ThisWillGoWell/DinoLight/images/neopixel_drver.png

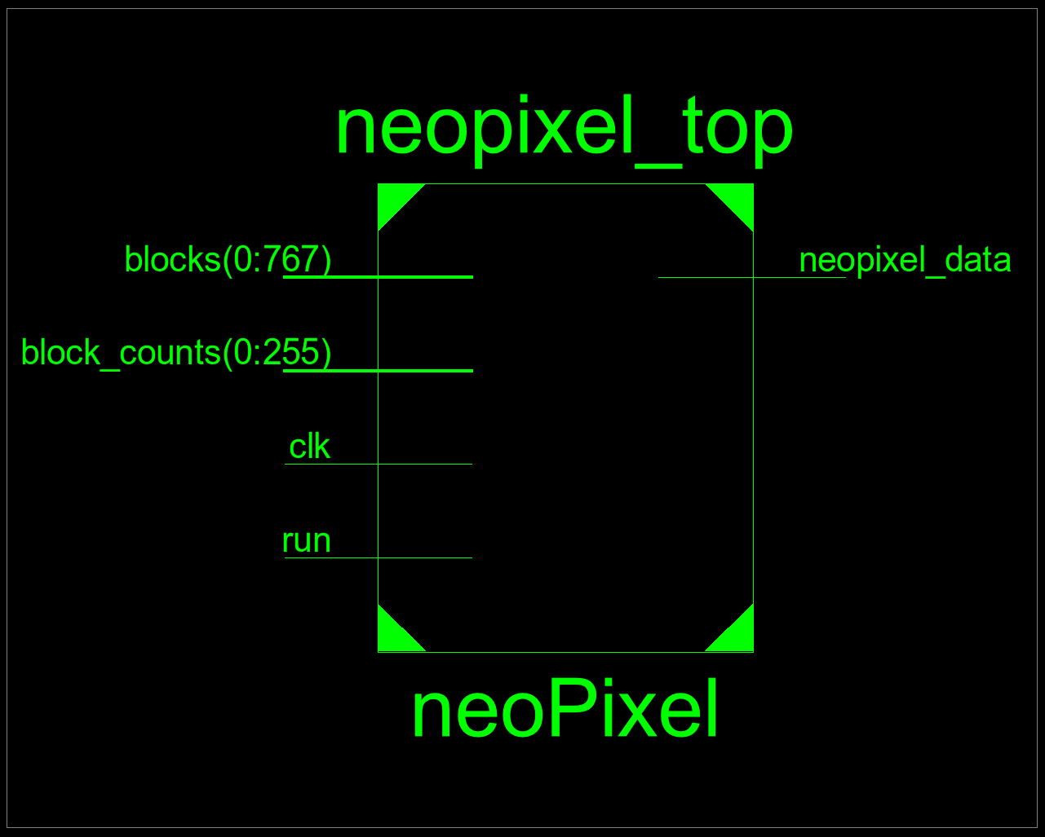
images/neopixel_drver.png
