ThisWillGoWell/DinoLight/images/projector-back.jpg

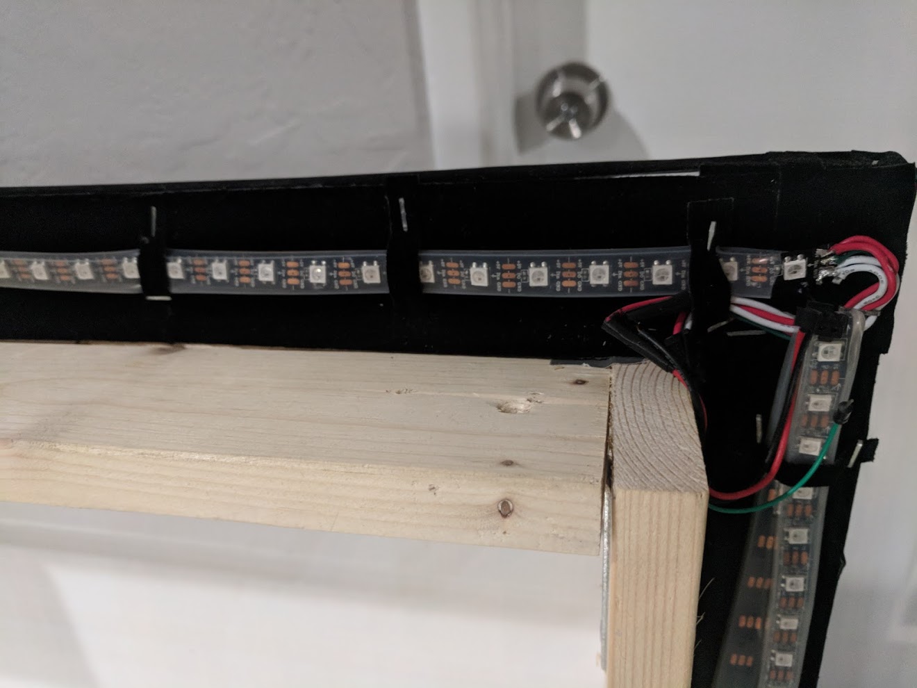
images/projector-back.jpg
