ThisWillGoWell/DinoLight/HDL/ise_project/dinolight/par_usage_statistics.html

Par Statistics

Total Non-vccgnd Signals=10460

Total Non-vccgnd Design Pins=26982

Total Non-vccgnd Conns=26982

Total Non-vccgnd Timing Constrained Conns=26282

Phase 1 CPU=5.9 sec

Phase 2 CPU=7.2 sec

Phase 3 CPU=19.3 sec

Phase 4 CPU=20.1 sec

Phase 5 CPU=31.5 sec

Phase 6 CPU=31.5 sec

Phase 7 CPU=31.5 sec

Phase 8 CPU=31.5 sec

Phase 9 CPU=31.5 sec

Phase 10 CPU=32.9 sec

AvgWirelenPerPin Fanout 1=2.0

AvgWirelenPerPin Fanout 2=1.5

AvgWirelenPerPin Fanout 3=1.0

AvgWirelenPerPin Fanout 4=3.8

AvgWirelenPerPin Fanout 10=2.5

AvgWirelenPerPin Fanout 50=8.6

AvgWirelenPerPin Fanout 100=10.8

AvgWirelenPerPin Fanout 500=8.4

AvgWirelenPerPin Fanout 5000=4.9

AvgWirelenPerPin Fanout 20000=0.0

AvgWirelenPerPin Fanout 50000=0.0

AvgWirelenPerPin Fanout 100000=0.0

IRR Gamma=4.1229
