ThisWillGoWell/DinoLight/HDL/ise_project/dinolight/usage_statistics_webtalk.html

### Device Usage Page (usage_statistics_webtalk.html)

This HTML page displays the device usage statistics that will be sent to Xilinx.

Software Version and Target Device
Product Version: | ISE:14.7 (WebPack) - P.20131013 | Target Family: | Spartan6
OS Platform: | LIN64 | Target Device: | xc6slx25
Project ID (random number) | 8b87126f18c546c1a701c0b1ea19649f.E9EB84C8A79649F5B47BB80CAE17756E.8 | Target Package: | ftg256
Registration ID | 211341362_0_0_377 | Target Speed: | -3
Date Generated | 2018-03-15T22:13:49 | Tool Flow | ISE

User Environment
OS Name | Ubuntu | OS Release | Ubuntu 16.04.3 LTS
CPU Name | Intel(R) Core(TM) i7-7700K CPU @ 4.20GHz | CPU Speed | 4200.000 MHz
OS Name | Ubuntu | OS Release | Ubuntu 16.04.3 LTS
CPU Name | Intel(R) Core(TM) i7-7700K CPU @ 4.20GHz | CPU Speed | 4200.000 MHz

Device Usage Statistics
Macro Statistics | Miscellaneous Statistics | Net Statistics | Site Usage

Accumulators=96

22-bit up accumulator=96

Adders/Subtractors=4

3-bit adder=2

9-bit adder=2

Comparators=45

11-bit comparator greater=18

11-bit comparator lessequal=16

12-bit comparator greater=4

3-bit comparator greater=2

5-bit comparator greater=1

7-bit comparator equal=1

8-bit comparator equal=1

9-bit comparator greater=2

Counters=11

11-bit up counter=2

12-bit up counter=1

15-bit up counter=1

24-bit up counter=1

4-bit up counter=2

5-bit up counter=1

6-bit up counter=1

7-bit up counter=1

8-bit up counter=1

FSMs=6 Multiplexers=3102

1-bit 2-to-1 multiplexer=3066

1-bit 8-to-1 multiplexer=1

10-bit 2-to-1 multiplexer=24

3-bit 2-to-1 multiplexer=4

9-bit 2-to-1 multiplexer=7

RAMs=4

256x8-bit single-port block Read Only RAM=3

4x8-bit single-port distributed Read Only RAM=1

Registers=8782

Flip-Flops=8782

Xors=1752

1-bit xor2=1746

5-bit xor2=3

9-bit xor2=3

MiscellaneousStatistics

AGG_BONDED_IO=20

AGG_IO=20

AGG_LOCED_IO=20

AGG_SLICE=2104

NUM_BONDED_IOB=20

NUM_BSFULL=5265

NUM_BSLUTONLY=452

NUM_BSREGONLY=2060

NUM_BSUSED=7777

NUM_BUFG=4

NUM_BUFPLL=1

NUM_ISERDES2=6

NUM_LOCED_IOB=20

NUM_LOGIC_O5ANDO6=603

NUM_LOGIC_O5ONLY=1161

NUM_LOGIC_O6ONLY=2852

NUM_LUT_RT_DRIVES_CARRY4=90

NUM_LUT_RT_DRIVES_FLOP=666

NUM_LUT_RT_EXO5=666

NUM_LUT_RT_EXO6=90

NUM_LUT_RT_O5=9

NUM_LUT_RT_O6=1161

NUM_PLL_ADV=1

NUM_RAMB8BWER=2

NUM_SLICEL=530

NUM_SLICEM=89

NUM_SLICEX=1485

NUM_SLICE_CARRY4=525

NUM_SLICE_CONTROLSET=83

NUM_SLICE_CYINIT=7916

NUM_SLICE_F7MUX=6

NUM_SLICE_FF=8884

NUM_SLICE_UNUSEDCTRL=168

NUM_SRL_O5ANDO6=336

NUM_SRL_O6ONLY=9

NUM_UNUSABLE_FF_BELS=267

NetStatistics

NumNets_Active=10480

NumNets_Gnd=1

NumNets_Vcc=1

NumNodesOfType_Active_BOUNCEACROSS=164

NumNodesOfType_Active_BOUNCEIN=1444

NumNodesOfType_Active_BUFGOUT=4

NumNodesOfType_Active_BUFHINP2OUT=27

NumNodesOfType_Active_CLKPIN=1944

NumNodesOfType_Active_CLKPINFEED=43

NumNodesOfType_Active_CNTRLPIN=1627

NumNodesOfType_Active_DOUBLE=9265

NumNodesOfType_Active_GENERIC=28

NumNodesOfType_Active_GENERIC1=5

NumNodesOfType_Active_GLOBAL=427

NumNodesOfType_Active_INPUT=817

NumNodesOfType_Active_IOBIN2OUT=14

NumNodesOfType_Active_IOBINPUT=3

NumNodesOfType_Active_IOBOUTPUT=23

NumNodesOfType_Active_LUTINPUT=18264

NumNodesOfType_Active_OUTBOUND=10060

NumNodesOfType_Active_OUTPUT=10544

NumNodesOfType_Active_PADINPUT=8

NumNodesOfType_Active_PADOUTPUT=10

NumNodesOfType_Active_PINBOUNCE=8168

NumNodesOfType_Active_PINFEED=20792

NumNodesOfType_Active_PINFEED2=6

NumNodesOfType_Active_QUAD=4630

NumNodesOfType_Active_REGINPUT=4310

NumNodesOfType_Active_SINGLE=14816

NumNodesOfType_Gnd_BOUNCEACROSS=2

NumNodesOfType_Gnd_BOUNCEIN=126

NumNodesOfType_Gnd_CNTRLPIN=13

NumNodesOfType_Gnd_DOUBLE=141

NumNodesOfType_Gnd_GENERIC=6

NumNodesOfType_Gnd_HGNDOUT=91

NumNodesOfType_Gnd_INPUT=36

NumNodesOfType_Gnd_IOBIN2OUT=6

NumNodesOfType_Gnd_IOBOUTPUT=6

NumNodesOfType_Gnd_LUTINPUT=1042

NumNodesOfType_Gnd_OUTBOUND=188

NumNodesOfType_Gnd_OUTPUT=218

NumNodesOfType_Gnd_PADINPUT=6

NumNodesOfType_Gnd_PINBOUNCE=129

NumNodesOfType_Gnd_PINFEED=1091

NumNodesOfType_Gnd_QUAD=4

NumNodesOfType_Gnd_SINGLE=268

NumNodesOfType_Vcc_CNTRLPIN=98

NumNodesOfType_Vcc_HVCCOUT=609

NumNodesOfType_Vcc_KVCCOUT=89

NumNodesOfType_Vcc_LUTINPUT=2801

NumNodesOfType_Vcc_PINBOUNCE=92

NumNodesOfType_Vcc_PINFEED=2804

SiteStatistics

BUFG-BUFGMUX=4

IOB-IOBM=11

IOB-IOBS=9

ISERDES2-ILOGIC2=6

SLICEL-SLICEM=158

SLICEX-SLICEL=309

SLICEX-SLICEM=328

SiteSummary

BUFG=4

BUFG_BUFG=4

BUFPLL=1

BUFPLL_BUFPLL=1

CARRY4=525

FF_SR=1561

HARD0=90

IOB=20

IOB_IMUX=6

IOB_INBUF=6

IOB_OUTBUF=10

ISERDES2=6

ISERDES2_ISERDES2=6

LUT5=2439

LUT6=4706

LUT_OR_MEM5=336

LUT_OR_MEM6=345

NULLMUX=4

PAD=20

PLL_ADV=1

PLL_ADV_PLL_ADV=1

RAMB8BWER=2

RAMB8BWER_RAMB8BWER=2

REG_SR=7323

SELMUX2_1=6

SLICEL=530

SLICEM=89

SLICEX=1485

Configuration Data

BUFPLL_BUFPLL

DATA_RATE=[SDR:1]

DIVIDE=[5:1]

ENABLE_SYNC=[TRUE:1]

FF_SR

CK=[CK:1561] [CK_INV:0]

SRINIT=[SRINIT0:1561]

SYNC_ATTR=[ASYNC:1114] [SYNC:447]

IOB_OUTBUF

DRIVEATTRBOX=[8:8] [12:2]

SLEW=[SLOW:10]

SUSPEND=[3STATE:10]

ISERDES2

CLK0=[CLK0_INV:0] [CLK0:6]

ISERDES2_ISERDES2

BITSLIP_ENABLE=[TRUE:6]

CLK0=[CLK0_INV:0] [CLK0:6]

DATA_RATE=[SDR:6]

DATA_WIDTH=[5:6]

INTERFACE_TYPE=[RETIMED:6]

SERDES_MODE=[SLAVE:3] [MASTER:3]

SHIFT_REGISTER_MODE=[FALSE:6]

LUT_OR_MEM5

CLK=[CLK:336] [CLK_INV:0]

LUT_OR_MEM=[RAM:336]

RAMMODE=[SRL16:336]

LUT_OR_MEM6

CLK=[CLK:345] [CLK_INV:0]

LUT_OR_MEM=[RAM:345]

RAMMODE=[SRL16:345]

PLL_ADV

RST=[RST:1] [RST_INV:0]

PLL_ADV_PLL_ADV

BANDWIDTH=[OPTIMIZED:1]

CLK_FEEDBACK=[CLKFBOUT:1]

COMPENSATION=[INTERNAL:1]

PLL_ADD_LEAKAGE=[2:1]

PLL_AVDD_COMP_SET=[2:1]

PLL_CLAMP_BYPASS=[FALSE:1]

PLL_CLAMP_REF_SEL=[1:1]

PLL_CLK0MX=[0:1]

PLL_CLK1MX=[0:1]

PLL_CLK2MX=[0:1]

PLL_CLK3MX=[0:1]

PLL_CLK4MX=[0:1]

PLL_CLK5MX=[0:1]

PLL_CLKBURST_CNT=[0:1]

PLL_CLKBURST_ENABLE=[TRUE:1]

PLL_CLKCNTRL=[0:1]

PLL_CLKFBMX=[0:1]

PLL_CLKFBOUT2_EDGE=[TRUE:1]

PLL_CLKFBOUT2_NOCOUNT=[TRUE:1]

PLL_CLKFBOUT_EDGE=[TRUE:1]

PLL_CLKFBOUT_EN=[FALSE:1]

PLL_CLKFBOUT_NOCOUNT=[TRUE:1]

PLL_CLKOUT0_EDGE=[TRUE:1]

PLL_CLKOUT0_EN=[FALSE:1]

PLL_CLKOUT0_NOCOUNT=[TRUE:1]

PLL_CLKOUT1_EDGE=[TRUE:1]

PLL_CLKOUT1_EN=[FALSE:1]

PLL_CLKOUT1_NOCOUNT=[TRUE:1]

PLL_CLKOUT2_EDGE=[TRUE:1]

PLL_CLKOUT2_EN=[FALSE:1]

PLL_CLKOUT2_NOCOUNT=[TRUE:1]

PLL_CLKOUT3_EDGE=[TRUE:1]

PLL_CLKOUT3_EN=[FALSE:1]

PLL_CLKOUT3_NOCOUNT=[TRUE:1]

PLL_CLKOUT4_EDGE=[TRUE:1]

PLL_CLKOUT4_EN=[FALSE:1]

PLL_CLKOUT4_NOCOUNT=[TRUE:1]

PLL_CLKOUT5_EDGE=[TRUE:1]

PLL_CLKOUT5_EN=[FALSE:1]

PLL_CLKOUT5_NOCOUNT=[TRUE:1]

PLL_CLK_LOST_DETECT=[FALSE:1]

PLL_CP=[1:1]

PLL_CP_BIAS_TRIP_SHIFT=[TRUE:1]

PLL_CP_REPL=[1:1]

PLL_CP_RES=[0:1]

PLL_DIRECT_PATH_CNTRL=[TRUE:1]

PLL_DIVCLK_EDGE=[TRUE:1]

PLL_DIVCLK_NOCOUNT=[TRUE:1]

PLL_DVDD_COMP_SET=[2:1]

PLL_EN=[FALSE:1]

PLL_EN_DLY=[TRUE:1]

PLL_EN_LEAKAGE=[2:1]

PLL_EN_TCLK0=[TRUE:1]

PLL_EN_TCLK1=[TRUE:1]

PLL_EN_TCLK2=[TRUE:1]

PLL_EN_TCLK3=[TRUE:1]

PLL_EN_VCO0=[FALSE:1]

PLL_EN_VCO1=[FALSE:1]

PLL_EN_VCO2=[FALSE:1]

PLL_EN_VCO3=[FALSE:1]

PLL_EN_VCO4=[FALSE:1]

PLL_EN_VCO5=[FALSE:1]

PLL_EN_VCO6=[FALSE:1]

PLL_EN_VCO7=[FALSE:1]

PLL_EN_VCO_DIV1=[FALSE:1]

PLL_EN_VCO_DIV6=[TRUE:1]

PLL_INTFB=[0:1]

PLL_IO_CLKSRC=[0:1]

PLL_LFHF=[3:1]

PLL_LOCK_FB_DLY=[3:1]

PLL_LOCK_REF_DLY=[5:1]

PLL_MAN_LF_EN=[TRUE:1]

PLL_NBTI_EN=[TRUE:1]

PLL_PFD_CNTRL=[8:1]

PLL_PFD_DLY=[1:1]

PLL_PWRD_CFG=[FALSE:1]

PLL_REG_INPUT=[TRUE:1]

PLL_RES=[1:1]

PLL_SEL_SLIPD=[FALSE:1]

PLL_SKEW_CNTRL=[0:1]

PLL_TEST_IN_WINDOW=[FALSE:1]

PLL_VDD_SEL=[0:1]

PLL_VLFHIGH_DIS=[TRUE:1]

RST=[RST:1] [RST_INV:0]

RAMB8BWER

CLKAWRCLK=[CLKAWRCLK:2] [CLKAWRCLK_INV:0]

CLKBRDCLK=[CLKBRDCLK_INV:0] [CLKBRDCLK:1]

ENAWREN=[ENAWREN:0] [ENAWREN_INV:2]

ENBRDEN=[ENBRDEN_INV:1] [ENBRDEN:0]

REGCEA=[REGCEA_INV:0] [REGCEA:2]

REGCEBREGCE=[REGCEBREGCE_INV:0] [REGCEBREGCE:1]

RSTA=[RSTA:2] [RSTA_INV:0]

RSTBRST=[RSTBRST:1] [RSTBRST_INV:0]

WEAWEL0=[WEAWEL0:2] [WEAWEL0_INV:0]

WEAWEL1=[WEAWEL1_INV:0] [WEAWEL1:2]

WEBWEU0=[WEBWEU0:1] [WEBWEU0_INV:0]

WEBWEU1=[WEBWEU1:1] [WEBWEU1_INV:0]

RAMB8BWER_RAMB8BWER

CLKAWRCLK=[CLKAWRCLK:2] [CLKAWRCLK_INV:0]

CLKBRDCLK=[CLKBRDCLK_INV:0] [CLKBRDCLK:1]

DATA_WIDTH_A=[9:2]

DATA_WIDTH_B=[0:1] [9:1]

DOA_REG=[0:2]

DOB_REG=[0:2]

ENAWREN=[ENAWREN:0] [ENAWREN_INV:2]

ENBRDEN=[ENBRDEN_INV:1] [ENBRDEN:0]

EN_RSTRAM_A=[TRUE:2]

EN_RSTRAM_B=[TRUE:2]

RAM_MODE=[TDP:2]

REGCEA=[REGCEA_INV:0] [REGCEA:2]

REGCEBREGCE=[REGCEBREGCE_INV:0] [REGCEBREGCE:1]

RSTA=[RSTA:2] [RSTA_INV:0]

RSTBRST=[RSTBRST:1] [RSTBRST_INV:0]

RSTTYPE=[SYNC:2]

RST_PRIORITY_A=[CE:2]

RST_PRIORITY_B=[CE:2]

WEAWEL0=[WEAWEL0:2] [WEAWEL0_INV:0]

WEAWEL1=[WEAWEL1_INV:0] [WEAWEL1:2]

WEBWEU0=[WEBWEU0:1] [WEBWEU0_INV:0]

WEBWEU1=[WEBWEU1:1] [WEBWEU1_INV:0]

WRITE_MODE_A=[WRITE_FIRST:2]

WRITE_MODE_B=[WRITE_FIRST:2]

REG_SR

CK=[CK:7323] [CK_INV:0]

LATCH_OR_FF=[FF:7323]

SRINIT=[SRINIT0:7321] [SRINIT1:2]

SYNC_ATTR=[ASYNC:4273] [SYNC:3050]

SLICEL

CLK=[CLK:506] [CLK_INV:0]

SLICEM

CLK=[CLK:89] [CLK_INV:0]

SLICEX

CLK=[CLK:1341] [CLK_INV:0]

Pin Data

BUFG

I0=4

O=4

BUFG_BUFG

I0=4

O=4

BUFPLL

GCLK=1

IOCLK=1

LOCKED=1

PLLIN=1

SERDESSTROBE=1

BUFPLL_BUFPLL

GCLK=1

IOCLK=1

LOCKED=1

PLLIN=1

SERDESSTROBE=1

CARRY4

CIN=435

CO3=435

CYINIT=90

DI0=525

DI1=441

DI2=438

DI3=435

O0=525

O1=525

O2=441

O3=438

S0=525

S1=525

S2=441

S3=438

FF_SR

CE=1081

CK=1561

D=1561

Q=1561

SR=19

HARD0

0=90

IOB

DIFFI_IN=4

I=6

O=10

PAD=20

PADOUT=4

IOB_IMUX

I=6

OUT=6

IOB_INBUF

DIFFI_IN=4

OUT=6

PAD=6

IOB_OUTBUF

IN=10

OUT=10

ISERDES2

BITSLIP=6

CE0=6

CLK0=6

CLKDIV=6

D=3

IOCE=6

Q1=3

Q2=3

Q3=3

Q4=6

RST=6

SHIFTIN=3

SHIFTOUT=3

ISERDES2_ISERDES2

BITSLIP=6

CE0=6

CLK0=6

CLKDIV=6

D=3

IOCE=6

Q1=3

Q2=3

Q3=3

Q4=6

RST=6

SHIFTIN=3

SHIFTOUT=3

LUT5

A1=443

A2=556

A3=460

A4=400

A5=619

O5=2439

LUT6

A1=1807

A2=1922

A3=2602

A4=4584

A5=2835

A6=4615

O6=4706

LUT_OR_MEM5

A1=336

A2=336

A3=336

A4=336

A5=336

CLK=336

DI1=336

O5=336

WE=336

LUT_OR_MEM6

A1=345

A2=345

A3=345

A4=345

A5=345

A6=345

CLK=345

DI2=345

O6=345

WE=345

NULLMUX

0=4

OUT=4

PAD

PAD=20

PLL_ADV

CLKFBIN=1

CLKFBOUT=1

CLKIN1=1

CLKOUT0=1

CLKOUT1=1

CLKOUT2=1

LOCKED=1

RST=1

PLL_ADV_PLL_ADV

CLKFBIN=1

CLKFBOUT=1

CLKIN1=1

CLKOUT0=1

CLKOUT1=1

CLKOUT2=1

LOCKED=1

RST=1

RAMB8BWER

ADDRAWRADDR10=2

ADDRAWRADDR11=2

ADDRAWRADDR12=2

ADDRAWRADDR3=2

ADDRAWRADDR4=2

ADDRAWRADDR5=2

ADDRAWRADDR6=2

ADDRAWRADDR7=2

ADDRAWRADDR8=2

ADDRAWRADDR9=2

ADDRBRDADDR10=1

ADDRBRDADDR11=1

ADDRBRDADDR12=1

ADDRBRDADDR3=1

ADDRBRDADDR4=1

ADDRBRDADDR5=1

ADDRBRDADDR6=1

ADDRBRDADDR7=1

ADDRBRDADDR8=1

ADDRBRDADDR9=1

CLKAWRCLK=2

CLKBRDCLK=1

DIADI0=2

DIADI1=2

DIADI2=2

DIADI3=2

DIADI4=2

DIADI5=2

DIADI6=2

DIADI7=2

DIPADIP0=2

DOADO0=2

DOADO1=2

DOADO2=2

DOADO3=2

DOADO4=2

DOADO5=2

DOADO6=2

DOADO7=2

DOBDO0=1

DOBDO1=1

DOBDO2=1

DOBDO3=1

DOBDO4=1

DOBDO5=1

DOBDO6=1

DOBDO7=1

ENAWREN=2

ENBRDEN=1

REGCEA=2

REGCEBREGCE=1

RSTA=2

RSTBRST=1

WEAWEL0=2

WEAWEL1=2

WEBWEU0=1

WEBWEU1=1

RAMB8BWER_RAMB8BWER

ADDRAWRADDR10=2

ADDRAWRADDR11=2

ADDRAWRADDR12=2

ADDRAWRADDR3=2

ADDRAWRADDR4=2

ADDRAWRADDR5=2

ADDRAWRADDR6=2

ADDRAWRADDR7=2

ADDRAWRADDR8=2

ADDRAWRADDR9=2

ADDRBRDADDR10=1

ADDRBRDADDR11=1

ADDRBRDADDR12=1

ADDRBRDADDR3=1

ADDRBRDADDR4=1

ADDRBRDADDR5=1

ADDRBRDADDR6=1

ADDRBRDADDR7=1

ADDRBRDADDR8=1

ADDRBRDADDR9=1

CLKAWRCLK=2

CLKBRDCLK=1

DIADI0=2

DIADI1=2

DIADI2=2

DIADI3=2

DIADI4=2

DIADI5=2

DIADI6=2

DIADI7=2

DIPADIP0=2

DOADO0=2

DOADO1=2

DOADO2=2

DOADO3=2

DOADO4=2

DOADO5=2

DOADO6=2

DOADO7=2

DOBDO0=1

DOBDO1=1

DOBDO2=1

DOBDO3=1

DOBDO4=1

DOBDO5=1

DOBDO6=1

DOBDO7=1

ENAWREN=2

ENBRDEN=1

REGCEA=2

REGCEBREGCE=1

RSTA=2

RSTBRST=1

WEAWEL0=2

WEAWEL1=2

WEBWEU0=1

WEBWEU1=1

REG_SR

CE=4126

CK=7323

D=7323

Q=7323

SR=1940

SELMUX2_1

0=6

1=6

OUT=6

S0=6

SLICEL

A=4

A1=4

A2=4

A3=5

A4=506

A5=29

A6=530

AMUX=25

AQ=506

AX=172

B=3

B1=3

B2=3

B3=3

B4=504

B5=24

B6=447

BMUX=25

BQ=505

BX=172

C=2

C1=7

C2=8

C3=8

C4=428

C5=29

C6=446

CE=499

CIN=435

CLK=506

CMUX=28

COUT=435

CQ=425

CX=176

D=6

D1=10

D2=11

D3=11

D4=428

D5=33

D6=448

DMUX=23

DQ=422

DX=172

SR=501

SLICEM

A1=87

A2=87

A3=87

A4=87

A5=87

A6=87

AI=87

AMUX=84

AQ=88

AX=85

B1=86

B2=86

B3=86

B4=86

B5=86

B6=86

BI=86

BMUX=84

BQ=88

BX=86

C1=86

C2=86

C3=86

C4=86

C5=86

C6=86

CE=89

CI=86

CLK=89

CMUX=84

CQ=87

CX=85

D1=86

D2=86

D3=86

D4=86

D5=86

D6=86

DI=86

DMUX=84

DQ=87

DX=85

SLICEX

A=349

A1=637

A2=707

A3=775

A4=890

A5=882

A6=814

AMUX=323

AQ=1298

AX=828

B=188

B1=525

B2=573

B3=606

B4=721

B5=713

B6=637

BMUX=324

BQ=1270

BX=816

C=155

C1=496

C2=542

C3=591

C4=699

C5=691

C6=615

CE=592

CLK=1341

CMUX=312

CQ=1276

CX=816

D=226

D1=562

D2=607

D3=637

D4=762

D5=748

D6=678

DMUX=310

DQ=1271

DX=817

SR=32

Tool Usage

Command Line History

xst -intstyle ise -ifn <ise_file>

ngdbuild -intstyle ise -dd _ngo -nt timestamp -uc <fname>.ucf -p xc6slx25-ftg256-3 <fname>.ngc <fname>.ngd

map -intstyle ise -p xc6slx25-ftg256-3 -w -logic_opt off -ol high -t 1 -xt 0 -register_duplication off -r 4 -global_opt off -mt off -detail -ir off -pr off -lc off -power off -o <fname>.ncd <fname>.ngd <fname>.pcf

par -w -intstyle ise -ol high -mt off <fname>.ncd <fname>.ncd <fname>.pcf

trce -intstyle ise -v 3 -s 3 -n 3 -fastpaths -xml <fname>.twx <fname>.ncd -o <fname>.twr <fname>.pcf

bitgen -intstyle ise -f <fname>.ut <fname>.ncd

xst -intstyle ise -ifn <ise_file>

ngdbuild -intstyle ise -dd _ngo -nt timestamp -uc <fname>.ucf -p xc6slx25-ftg256-3 <fname>.ngc <fname>.ngd

map -intstyle ise -p xc6slx25-ftg256-3 -w -logic_opt off -ol high -t 1 -xt 0 -register_duplication off -r 4 -global_opt off -mt off -detail -ir off -pr off -lc off -power off -o <fname>.ncd <fname>.ngd <fname>.pcf

par -w -intstyle ise -ol high -mt off <fname>.ncd <fname>.ncd <fname>.pcf

trce -intstyle ise -v 3 -s 3 -n 3 -fastpaths -xml <fname>.twx <fname>.ncd -o <fname>.twr <fname>.pcf

bitgen -intstyle ise -f <fname>.ut <fname>.ncd

xst -intstyle ise -ifn <ise_file>

ngdbuild -intstyle ise -dd _ngo -nt timestamp -uc <fname>.ucf -p xc6slx25-ftg256-3 <fname>.ngc <fname>.ngd

map -intstyle ise -p xc6slx25-ftg256-3 -w -logic_opt off -ol high -t 1 -xt 0 -register_duplication off -r 4 -global_opt off -mt off -detail -ir off -pr off -lc off -power off -o <fname>.ncd <fname>.ngd <fname>.pcf

map -intstyle ise -p xc6slx25-ftg256-3 -w -logic_opt off -ol high -t 1 -xt 0 -register_duplication off -r 4 -global_opt off -mt off -detail -ir off -pr off -lc off -power off -o <fname>.ncd <fname>.ngd <fname>.pcf

par -w -intstyle ise -ol high -mt off <fname>.ncd <fname>.ncd <fname>.pcf

trce -intstyle ise -v 3 -s 3 -n 3 -fastpaths -xml <fname>.twx <fname>.ncd -o <fname>.twr <fname>.pcf

bitgen -intstyle ise -f <fname>.ut <fname>.ncd

xst -intstyle ise -ifn <ise_file>

xst -intstyle ise -ifn <ise_file>

xst -intstyle ise -ifn <ise_file>

xst -intstyle ise -ifn <ise_file>

xst -intstyle ise -ifn <ise_file>

xst -intstyle ise -ifn <ise_file>

xst -intstyle ise -ifn <ise_file>

xst -intstyle ise -ifn <ise_file>

xst -intstyle ise -ifn <ise_file>

xst -intstyle ise -ifn <ise_file>

xst -intstyle ise -ifn <ise_file>

ngdbuild -intstyle ise -dd _ngo -nt timestamp -uc <fname>.ucf -p xc6slx25-ftg256-3 <fname>.ngc <fname>.ngd

map -intstyle ise -p xc6slx25-ftg256-3 -w -logic_opt off -ol high -t 1 -xt 0 -register_duplication off -r 4 -global_opt off -mt off -detail -ir off -pr off -lc off -power off -o <fname>.ncd <fname>.ngd <fname>.pcf

par -w -intstyle ise -ol high -mt off <fname>.ncd <fname>.ncd <fname>.pcf

trce -intstyle ise -v 3 -s 3 -n 3 -fastpaths -xml <fname>.twx <fname>.ncd -o <fname>.twr <fname>.pcf

bitgen -intstyle ise -f <fname>.ut <fname>.ncd

Software Quality
Run Statistics
Program Name | Runs Started | Runs Finished | Errors | Fatal Errors | Internal Errors | Exceptions | Core Dumps
bitgen | 1 | 1 | 0 | 0 | 0 | 0 | 0
map | 1 | 1 | 0 | 0 | 0 | 0 | 0
ngdbuild | 1 | 1 | 0 | 0 | 0 | 0 | 0
par | 1 | 1 | 0 | 0 | 0 | 0 | 0
trce | 1 | 1 | 0 | 0 | 0 | 0 | 0
xst | 11 | 11 | 0 | 0 | 0 | 0 | 0

Project Statistics
PROP_Enable_Message_Filtering=false | PROP_FitterReportFormat=HTML
PROP_LastAppliedGoal=Balanced | PROP_LastAppliedStrategy=Xilinx Default (unlocked)
PROP_ManualCompileOrderImp=false | PROP_PropSpecInProjFile=Store all values
PROP_Simulator=ISim (VHDL/Verilog) | PROP_SynthTopFile=changed
PROP_Top_Level_Module_Type=HDL | PROP_UseSmartGuide=false
PROP_UserBrowsedStrategyFiles=C:/Xilinx/14.7/ISE_DS/ISE/data/default.xds | PROP_UserConstraintEditorPreference=Text Editor
PROP_intProjectCreationTimestamp=2017-04-25T12:22:24 | PROP_intWbtProjectID=E9EB84C8A79649F5B47BB80CAE17756E
PROP_intWbtProjectIteration=8 | PROP_intWorkingDirLocWRTProjDir=Same
PROP_intWorkingDirUsed=No | PROP_xilxBitgStart_IntDone=true
PROP_xilxMapReportDetail=true | PROP_AutoTop=true
PROP_DevFamily=Spartan6 | PROP_DevDevice=xc6slx25
PROP_DevFamilyPMName=spartan6 | PROP_DevPackage=ftg256
PROP_Synthesis_Tool=XST (VHDL/Verilog) | PROP_DevSpeed=-3
PROP_PreferredLanguage=VHDL | FILE_UCF=1

FILE_VHDL=23

Unisim Statistics
XST_UNISIM_SUMMARY
XST_NUM_BUFG=1 | XST_NUM_BUFPLL=1 | XST_NUM_IBUFDS=3 | XST_NUM_ISERDES2=2
NGDBUILD_PRE_UNISIM_SUMMARY
NGDBUILD_NUM_BUFG=4 | NGDBUILD_NUM_BUFGP=1 | NGDBUILD_NUM_BUFPLL=1 | NGDBUILD_NUM_FD=2945
NGDBUILD_NUM_FDE=2442 | NGDBUILD_NUM_FDR=51 | NGDBUILD_NUM_FDRE=3446 | NGDBUILD_NUM_GND=1
NGDBUILD_NUM_IBUF=1 | NGDBUILD_NUM_IBUFDS=4 | NGDBUILD_NUM_INV=33 | NGDBUILD_NUM_ISERDES2=6
NGDBUILD_NUM_LUT1=1251 | NGDBUILD_NUM_LUT2=757 | NGDBUILD_NUM_LUT3=1165 | NGDBUILD_NUM_LUT4=184
NGDBUILD_NUM_LUT5=117 | NGDBUILD_NUM_LUT6=1797 | NGDBUILD_NUM_MUXCY=1839 | NGDBUILD_NUM_MUXF7=6
NGDBUILD_NUM_OBUF=10 | NGDBUILD_NUM_OBUFT=2 | NGDBUILD_NUM_RAMB8BWER=2 | NGDBUILD_NUM_SRLC16E=681
NGDBUILD_NUM_VCC=1 | NGDBUILD_NUM_XORCY=1929
NGDBUILD_POST_UNISIM_SUMMARY
NGDBUILD_NUM_BUFG=5 | NGDBUILD_NUM_BUFPLL=1 | NGDBUILD_NUM_FD=2945 | NGDBUILD_NUM_FDE=2442
NGDBUILD_NUM_FDR=51 | NGDBUILD_NUM_FDRE=3446 | NGDBUILD_NUM_GND=1 | NGDBUILD_NUM_IBUF=1
NGDBUILD_NUM_IBUFDS=4 | NGDBUILD_NUM_IBUFG=1 | NGDBUILD_NUM_INV=33 | NGDBUILD_NUM_ISERDES2=6
NGDBUILD_NUM_LUT1=1251 | NGDBUILD_NUM_LUT2=757 | NGDBUILD_NUM_LUT3=1165 | NGDBUILD_NUM_LUT4=184
NGDBUILD_NUM_LUT5=117 | NGDBUILD_NUM_LUT6=1797 | NGDBUILD_NUM_MUXCY=1839 | NGDBUILD_NUM_MUXF7=6
NGDBUILD_NUM_OBUF=10 | NGDBUILD_NUM_OBUFT=2 | NGDBUILD_NUM_PLL_ADV=1 | NGDBUILD_NUM_RAMB8BWER=2
NGDBUILD_NUM_SRLC16E=681 | NGDBUILD_NUM_VCC=1 | NGDBUILD_NUM_XORCY=1929

XST Command Line Options
XST_OPTION_SUMMARY
-ifn=<fname>.prj | -ofn=<design_top> | -ofmt=NGC | -p=xc6slx25-3-ftg256
-top=<design_top> | -opt_mode=Speed | -opt_level=1 | -power=NO
-iuc=NO | -keep_hierarchy=No | -netlist_hierarchy=As_Optimized | -rtlview=Yes
-glob_opt=AllClockNets | -read_cores=YES | -write_timing_constraints=NO | -cross_clock_analysis=NO
-bus_delimiter=<> | -slice_utilization_ratio=100 | -bram_utilization_ratio=100 | -dsp_utilization_ratio=100
-reduce_control_sets=Auto | -fsm_extract=YES | -fsm_encoding=Auto | -safe_implementation=No
-fsm_style=LUT | -ram_extract=Yes | -ram_style=Auto | -rom_extract=Yes
-shreg_extract=YES | -rom_style=Auto | -auto_bram_packing=NO | -resource_sharing=YES
-async_to_sync=NO | -use_dsp48=Auto | -iobuf=YES | -max_fanout=100000
-bufg=16 | -register_duplication=YES | -register_balancing=No | -optimize_primitives=NO
-use_clock_enable=Auto | -use_sync_set=Auto | -use_sync_reset=Auto | -iob=Auto
-equivalent_register_removal=YES | -slice_utilization_ratio_maxmargin=5
