ThisWillGoWell/DinoLight/(commit log)

2018-03-15 init commit
    [dinolight_pad.csv, dlp2232m.csv, dlp2232m.ods, ft2232_cable.sch, par_cable.sch]
2018-03-16 image
    Former-commit-id: 081de5e0bb2d656fb441f949fbaf71cca00a47d6
    [dinolight_pad.csv]
2019-04-25 🤘
    🤷‍♂️
